CircuitMonkey/edge-lord-2000/README.md

# edge-lord-2000
ESP32 based vibrator controller, four channel, OLED screen
