CircuitMonkey/edge-lord-2000/Documents/edge-lord-2000-bom.ods

EdgeLord-2000 Vibrator Controller |  |  | 2022-04-19
Part | Value | Package | Description | HAVE | COST01 | COST10 | COST100 | MFR | ALT MPN
C2 | XXuF/xxV - 6.3mm | CAP_ALUM_SMT_6.3 | Polarized Capacitor
C3 | XXuF/xxV - 6.3mm | CAP_ALUM_SMT_6.3 | Polarized Capacitor
C4 | XXuF/xxV - 6.3mm | CAP_ALUM_SMT_6.3 | Polarized Capacitor
C5 | XXuF/xxV - 6.3mm | CAP_ALUM_SMT_6.3 | Polarized Capacitor
C6 | 0.1uF | 0603-CAP | Capacitor |  | $0.10 | $0.05 | $0.02
C7 | 0.1uF | 0603-CAP | Capacitor |  | $0.10 | $0.05 | $0.02
C8 | 0.1uF | 0603-CAP | Capacitor |  | $0.10 | $0.05 | $0.02
C9 | 0.1uF | 0603-CAP | Capacitor |  | $0.10 | $0.05 | $0.02
C11 | 1uF | 0603-CAP | Capacitor |  | $0.10 | $0.05 | $0.02
C12 | 1uF | 0603-CAP | Capacitor |  | $0.10 | $0.05 | $0.02
C13 | 1uF | 0603-CAP | Capacitor |  | $0.10 | $0.05 | $0.02
FUSE | Belfuse 0ZCJxxx | BELFUSE-1206 | Fuse
HUZZAH | AdaFruit Huzzah ESP32 | ADAFRUIT_HUZZAH32 | AdaFruit Huzzah32 |  | $23.00 | $20.00 | $17.00 | AdaFruit
MOTORS | Header, 8P | MA08X1-RA-THD | Header, 8-pin, 1-row, 2.54mm |  | $0.05 | $0.04 | $0.03
OLED | GREYSCALE | SSD1327-THD-MODULE | OLED Module, THD, COLOR, 128x128 |  | $20.00 | $16.00 | $7.00 | Amazon
Q1 | SI2302CDS | SOT-23 | FET
Q2 | SI2302CDS | SOT-23 | FET
Q3 | SI2302CDS | SOT-23 | FET
Q4 | SI2302CDS | SOT-23 | FET
Q5 | ON Semi NTS4173P | SOT-323 | P-FET (PFET) |  |  |  |  |  | RSU002P03T106
Q6 | 2N7002 | SOT-23 | FET |  | $0.20 | $0.16 | $0.09
R1 | 100K | 0603-RES | Resistor |  | $0.10 | $0.05 | $0.02
R2 | 100K | 0603-RES | Resistor |  | $0.10 | $0.05 | $0.02
R3 | 20K | 0603-RES | Resistor |  | $0.10 | $0.05 | $0.02
R4 | 330R | 0603-RES | Resistor |  | $0.10 | $0.05 | $0.02
R5 | 100K | 0603-RES | Resistor |  | $0.10 | $0.05 | $0.02
R6 | 100K | 0603-RES | Resistor |  | $0.10 | $0.05 | $0.02
R7 | 100K | 0603-RES | Resistor |  | $0.10 | $0.05 | $0.02
RGB1 | WS2812B | SMD_3535 | Smart LED SK6812 WS2812 |  | $0.12 | $0.10 | $0.08
RGB2 | WS2812B | SMD_3535 | Smart LED SK6812 WS2812 |  | $0.12 | $0.10 | $0.08
RGB3 | WS2812B | SMD_3535 | Smart LED SK6812 WS2812 |  | $0.12 | $0.10 | $0.08
RIGHT | Push Switch | B3SN | Pushbutton Switch |  | $1.05 | $0.95 | $0.75 | Omron
STOP | Push Switch | B3SN | Pushbutton Switch |  | $1.05 | $0.95 | $0.75 | Omron
UP | Push Switch | B3SN | Pushbutton Switch |  | $1.05 | $0.95 | $0.75 | Omron
DOWN | Push Switch | B3SN | Pushbutton Switch |  | $1.05 | $0.95 | $0.75 | Omron
ENTER | Push Switch | B3SN | Pushbutton Switch |  | $1.05 | $0.95 | $0.75 | Omron
LEFT | Push Switch | B3SN | Pushbutton Switch |  | $1.05 | $0.95 | $0.75 | Omron
PWR | SPDT | CK_JS102011JCQN | Slide Switch - SPDT
