CircuitMonkey/edge-lord-2000/Documents/edge-lord-2000.pdf

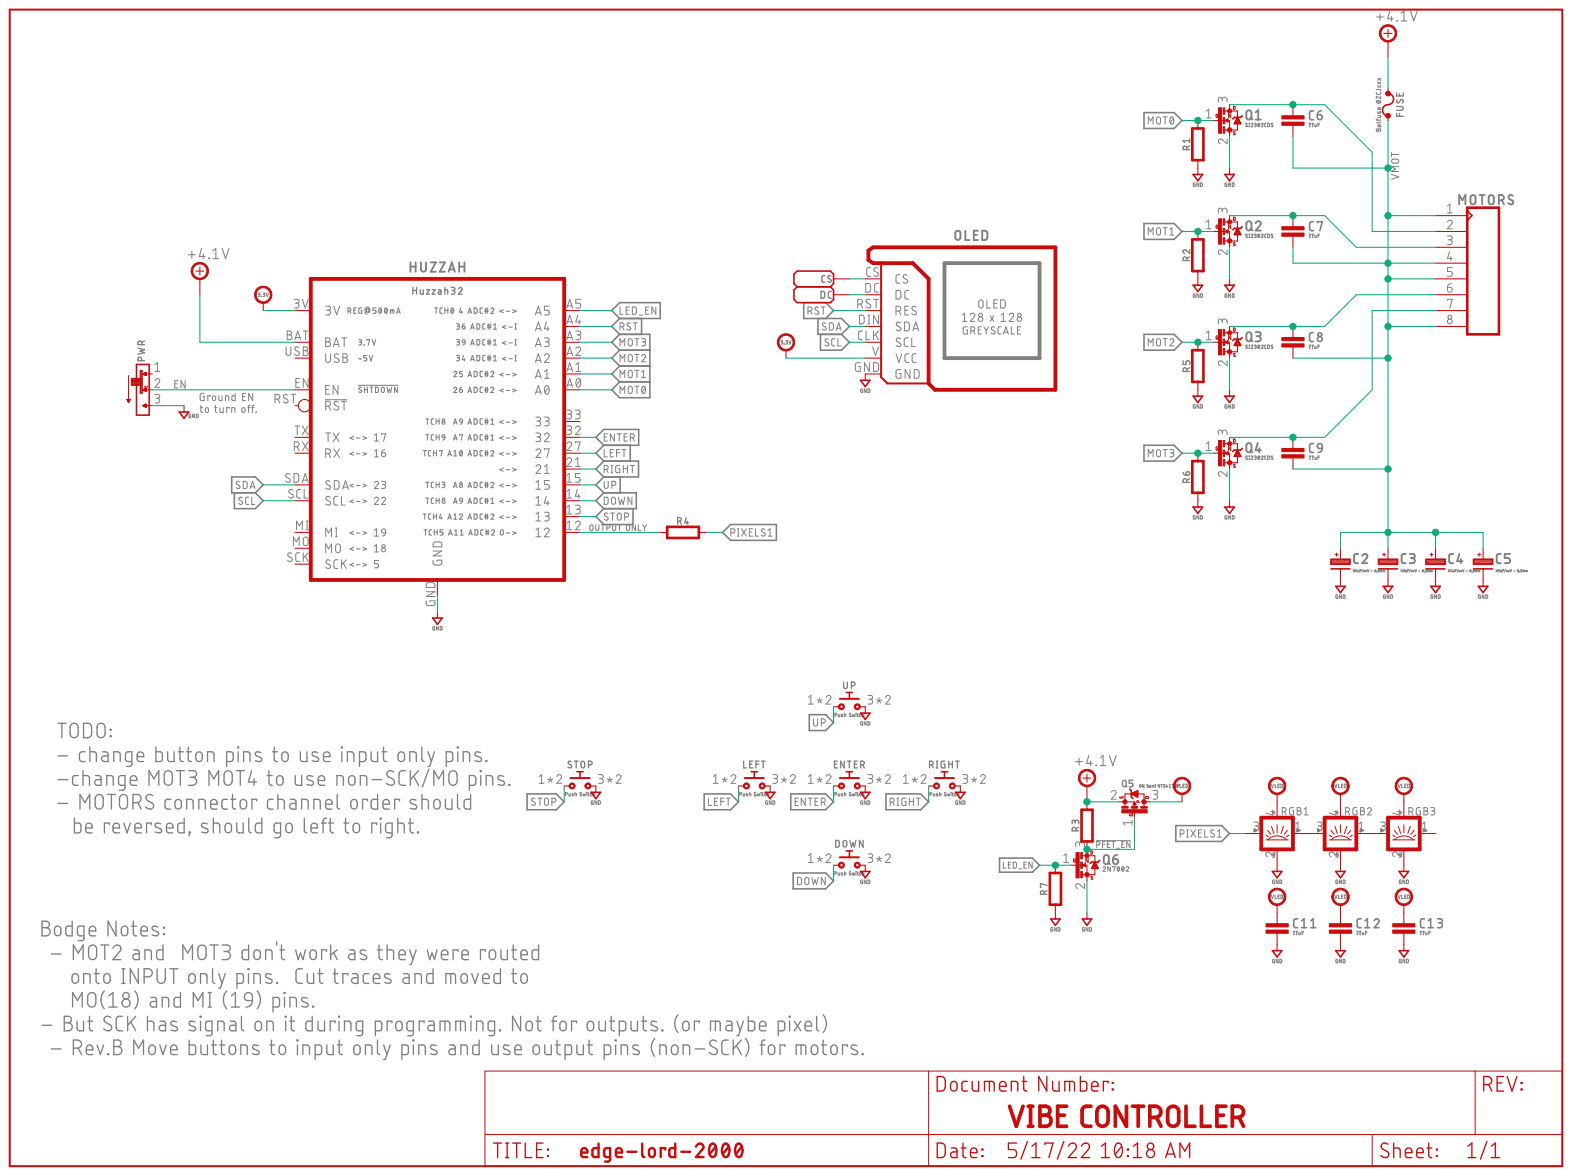
[picture p1: page 1]
