CircuitMonkey/edge-lord-2000/PCB/edge-lord-2000.brd

## EAGLE design PCB/edge-lord-2000.brd (2022-05-17)

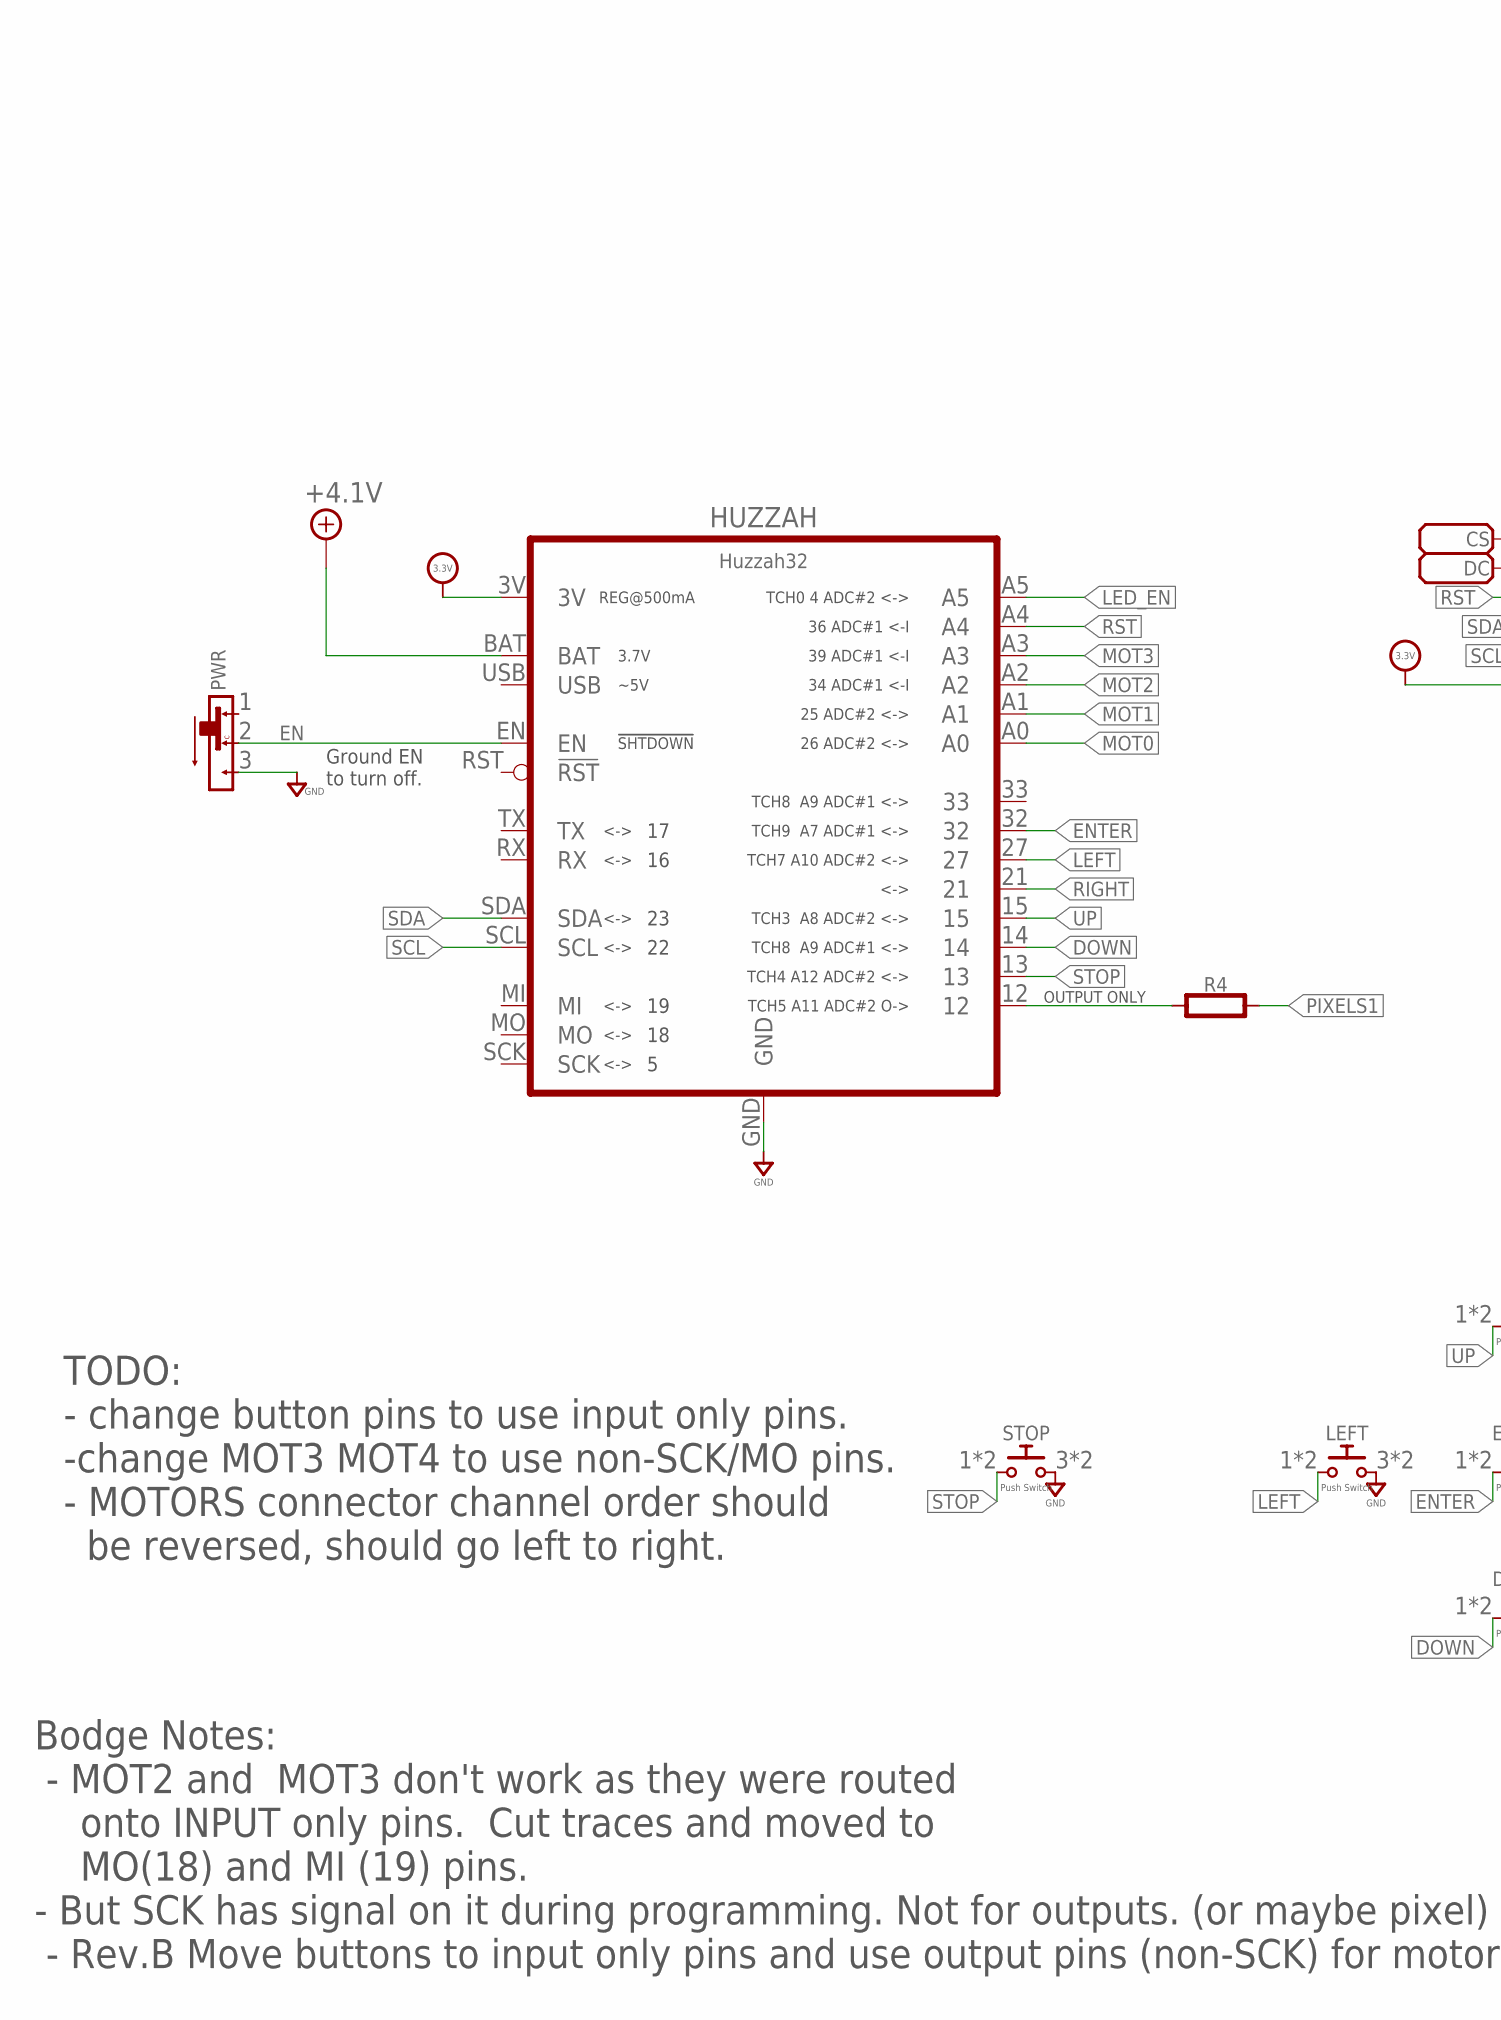
[picture p2: schematic edge-lord-2000.sch, part in row 1, column 1]

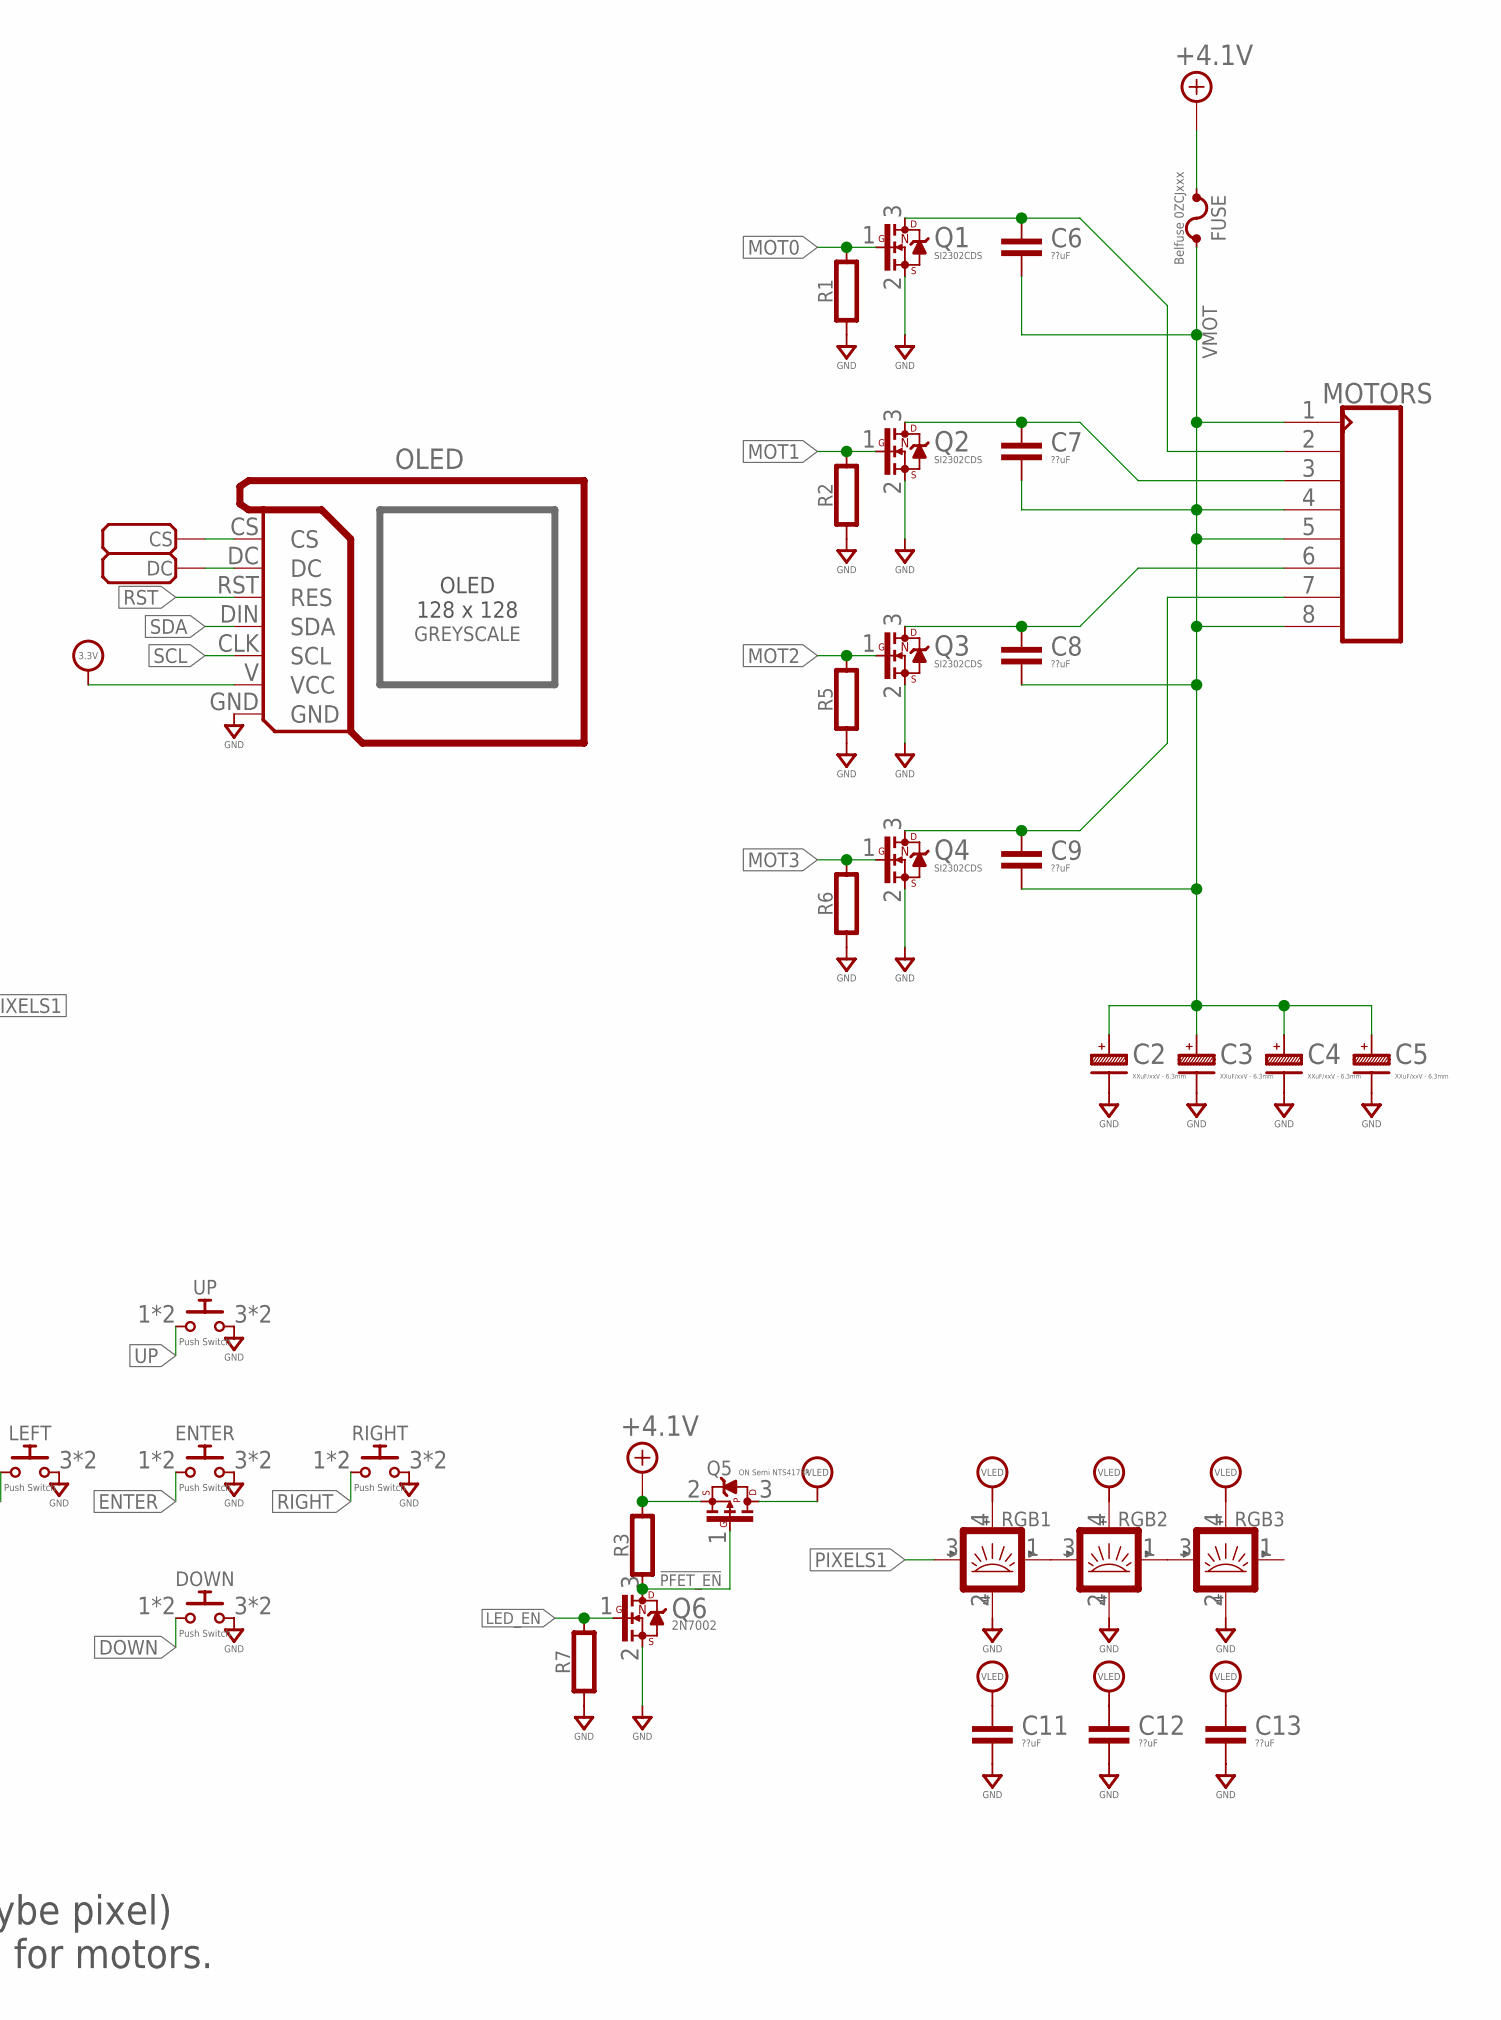
[picture p3: schematic edge-lord-2000.sch, part in row 1, column 2]

Parts:
C2, C3, C4, C5: XXuF/xxV - 6.3mm; CAP_ALUM_SMT_6.3
C6, C7, C8, C9, C11, C12, C13: ??uF; 0603-CAP
CS: PADSMD-070X070; SMD-070MIL
DC: PADSMD-070X070; SMD-070MIL
DOWN: Push Switch; B3SN
ENTER: Push Switch; B3SN
FUSE: Belfuse 0ZCJxxx; BELFUSE-1206
HUZZAH: Huzzah32; ADAFRUIT_HUZZAH32
LEFT: Push Switch; B3SN
MOTORS: CON_08X1-RA-THD; MA08X1-RA-THD
OLED: GREYSCALE; SSD1327-THD-MODULE
PWR: SLIDE-SPDTJS102011JCQN; CK_JS102011JCQN
Q1, Q2, Q3, Q4: SI2302CDS; SOT-23
Q5: ON Semi NTS4173P; SOT-323
Q6: 2N7002; SOT-23
R1, R2, R5, R6, R7: 100K; 0603-RES
R3: 20K; 0603-RES
R4: 330; 0603-RES
RGB1, RGB2, RGB3: SMART_LED3535; SMD_3535
RIGHT: Push Switch; B3SN
STOP: Push Switch; B3SN
UP: Push Switch; B3SN

Connections:
!PFET_EN: Q5.1 (G), Q6.3 (D), R3.1
+3.3V: HUZZAH.3V, OLED.V (VCC)
+4.1V: FUSE.1, HUZZAH.BAT, Q5.2 (S), R3.2
DOWN: DOWN.1, DOWN.2 (1), HUZZAH.14
EN: HUZZAH.EN, PWR.2
ENTER: ENTER.1, ENTER.2 (1), HUZZAH.32
GND: C2.- (N), C3.- (N), C4.- (N), C5.- (N), C11.2, C12.2, C13.2, DOWN.3 (2), DOWN.4 (2), ENTER.3 (2), ENTER.4 (2), HUZZAH.GND, LEFT.3 (2), LEFT.4 (2), OLED.GND, PWR.3, Q1.2 (S), Q2.2 (S), Q3.2 (S), Q4.2 (S), Q6.2 (S), R1.1, R2.1, R5.1, R6.1, R7.1, RGB1.2 (GND), RGB2.2 (GND), RGB3.2 (GND), RIGHT.3 (2), RIGHT.4 (2), STOP.3 (2), STOP.4 (2), UP.3 (2), UP.4 (2)
LED_EN: HUZZAH.A5, Q6.1 (G), R7.2
LEFT: HUZZAH.27, LEFT.1, LEFT.2 (1)
MOT0: HUZZAH.A0, Q1.1 (G), R1.2
MOT1: HUZZAH.A1, Q2.1 (G), R2.2
MOT2: HUZZAH.A2, Q3.1 (G), R5.2
MOT3: HUZZAH.A3, Q4.1 (G), R6.2
unnamed: C6.1, MOTORS.2, Q1.3 (D)
unnamed: C8.1, MOTORS.6, Q3.3 (D)
unnamed: C7.1, MOTORS.3, Q2.3 (D)
unnamed: CS.1, OLED.CS
unnamed: DC.1, OLED.DC
unnamed: RGB1.1 (OUT), RGB2.3 (IN)
unnamed: RGB2.1 (OUT), RGB3.3 (IN)
unnamed: HUZZAH.12, R4.1
unnamed: C9.1, MOTORS.7, Q4.3 (D)
PIXELS1: R4.2, RGB1.3 (IN)
RIGHT: HUZZAH.21, RIGHT.1, RIGHT.2 (1)
RST: HUZZAH.A4, OLED.RST (RES)
SCL: HUZZAH.SCL, OLED.CLK (SCL)
SDA: HUZZAH.SDA, OLED.DIN (SDA)
STOP: HUZZAH.13, STOP.1, STOP.2 (1)
UP: HUZZAH.15, UP.1, UP.2 (1)
VLED: C11.1, C12.1, C13.1, Q5.3 (D), RGB1.4 (VDD), RGB2.4 (VDD), RGB3.4 (VDD)
VMOT: C2.+, C3.+, C4.+, C5.+, C6.2, C7.2, C8.2, C9.2, FUSE.2, MOTORS.1, MOTORS.4, MOTORS.5, MOTORS.8

Notes on the sheet:
OUTPUT ONLY
TODO: - change button pins to use input only pins. -change MOT3 MOT4 to use non-SCK/MO pins. - MOTORS connector channel order should be reversed, should go left to right.
Ground EN to turn off.
Bodge Notes: - MOT2 and MOT3 don't work as they were routed onto INPUT only pins. Cut traces and moved to MO(18) and MI (19) pins. - But SCK has signal on it during programming. Not for outputs. (or maybe pixel) - Rev.B Move buttons to input only pins and use output pins (non-SCK) for motors.

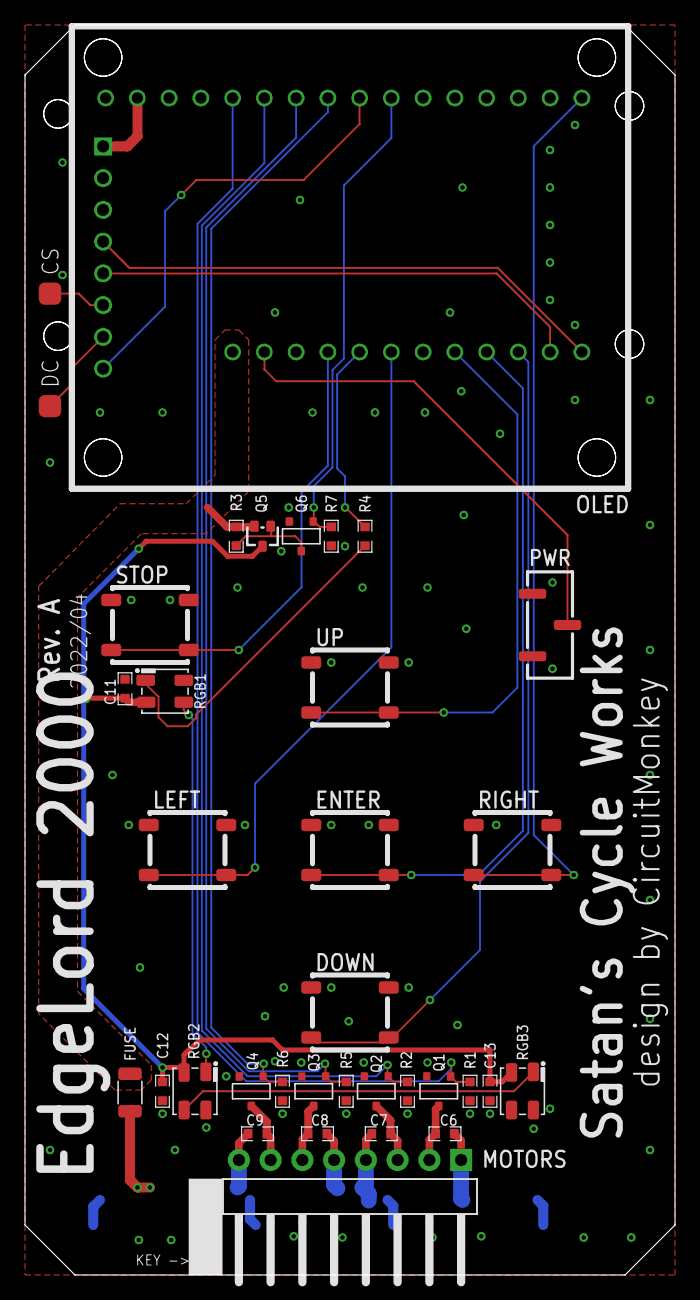
[picture p4: board edge-lord-2000.brd from above]

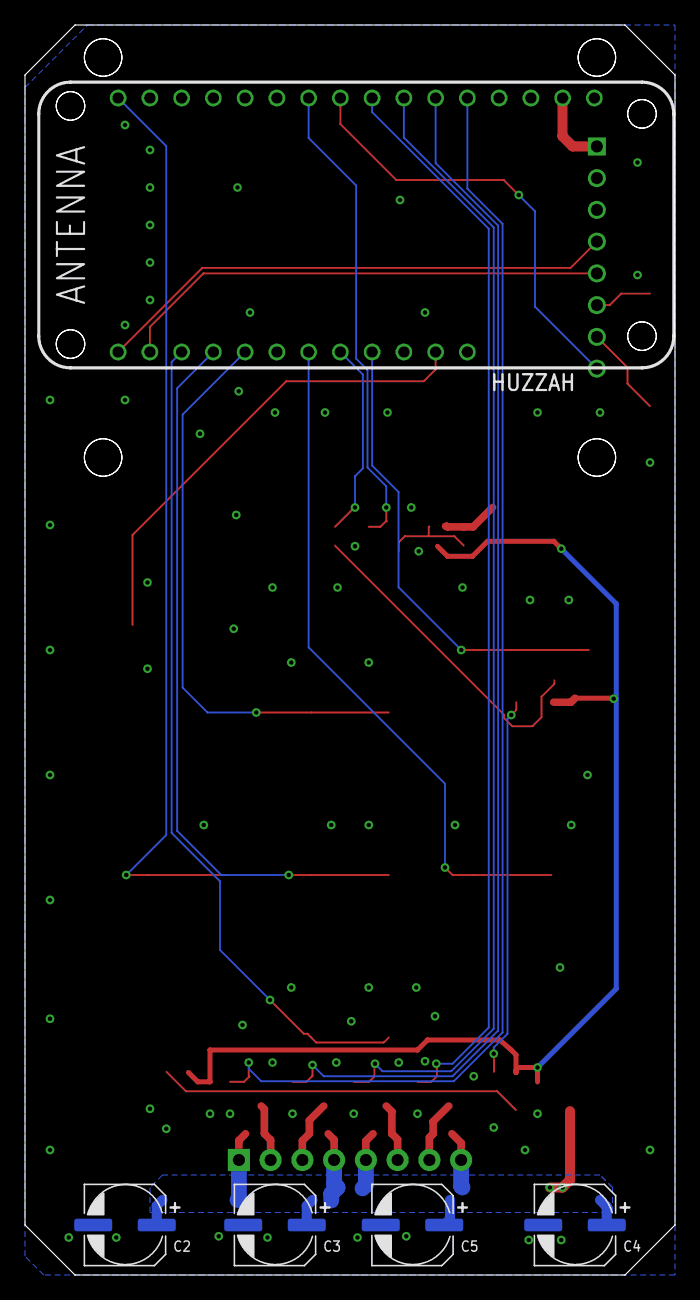
[picture p5: board edge-lord-2000.brd from below]

Board: 2 copper layers, 52.0 x 100.0 mm, 40 parts (5 on the bottom side), 31 nets.
