CircuitMonkey/edge-lord-2000/Code/edge-lord/OledGlyphs.h

// [glyph16m]  glyph  16x16   monochrome as bits
// [glyph16g]  glyph  16x16   greyscale  as nybles
#ifndef OledGlyphs_h 
#define OledGlyphs_h

#define G_WH 16

static const unsigned char PROGMEM glyph16m_blank[] = { 
  B00000000, B00000000,
  B00000000, B00000000,
  B00000000, B00000000,
  B00000000, B00000000,
  B00000000, B00000000,
  B00000000, B00000000,
  B00000000, B00000000,
  B00000000, B00000000,
  B00000000, B00000000,
  B00000000, B00000000,
  B00000000, B00000000,
  B00000000, B00000000,
  B00000000, B00000000,
  B00000000, B00000000,
  B00000000, B00000000,
  B00000000, B00000000 
};

static const unsigned char PROGMEM glyph16m_sliders[] = { 
  B00000000, B00000000,
  B00000000, B00000000,
  B00100010, B00100010,
  B00100010, B00100010,  
  B00100010, B00100010,
  B00100010, B00100111,
  B01110010, B00100111,
  B01110010, B00100010,  
  B00100111, B00100010,
  B00100111, B00100010,
  B00100010, B00100010,
  B00100010, B01110010,  
  B00100010, B01110010,
  B00100010, B00100010,
  B00000000, B00000000,
  B00000000, B00000000 
};

static const unsigned char PROGMEM glyph16m_cycle[] = { 
  B00000000, B00010000,
  B00010000, B00011000,
  B00111011, B11111100,
  B01111101, B11111110,
  B11111110, B11111100,
  B00111000, B00011000,
  B00111000, B00010100,
  B00111000, B00001100,
  B00110000, B00011100,
  B00101000, B00011100,
  B00011000, B00011100,
  B00111111, B01111111,
  B01111111, B10111110,
  B00111111, B11011100,
  B00011000, B00001000,
  B00001000, B00000000 
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
  B01111111, B11100000,
  B01111111, B11100000,
  B00111111, B10100000,
  
  B00011111, B10010000,
  B00001100, B10001000,
  B00000000, B01001000,
  B00000000, B00100100,
  B00000000, B00100010,
  B00000000, B00010010,
  B00000000, B00001011,
  B00000000, B00001100,
};

#endif
