CircuitMonkey/edge-lord-2000/(commit log)

2022-04-19 Rev. A (final?)
    [edge-lord-2000.brd, edge-lord-2000.sch]
2022-04-20 PWR switch was backward. Updated 3D model for fusion.
    [edge-lord-2000.brd, edge-lord-2000.sch]
2022-05-05 PCB Rev.A tweaks.
    [edge-lord-2000.brd, edge-lord-2000.sch]
2022-05-05 Individual tests for PCB function.
2022-05-11 Bodge Notes added to schematic
    [edge-lord-2000.sch]
2022-05-17 Stop animation timer if paused.
2022-05-17 More notes in PCB. Update Huzzah symbol.
    [edge-lord-2000.brd, edge-lord-2000.sch]
2022-05-31 Fix issue where N_SLIDERS was not properly referenced.
    [ModeCross.cpp, ModeCycle.cpp, ModeLeftRight.cpp, ModeManual.cpp, ModeRandom.cpp, ModeUpDown.cpp]
2022-05-31 Add Hammer Mode. More motor speed. Add Debounce.
